WiktorKociuba/drone/dronePCB/dronePCB.kicad_pcb

## KiCad design dronePCB/dronePCB.kicad_pcb (2026-04-25)

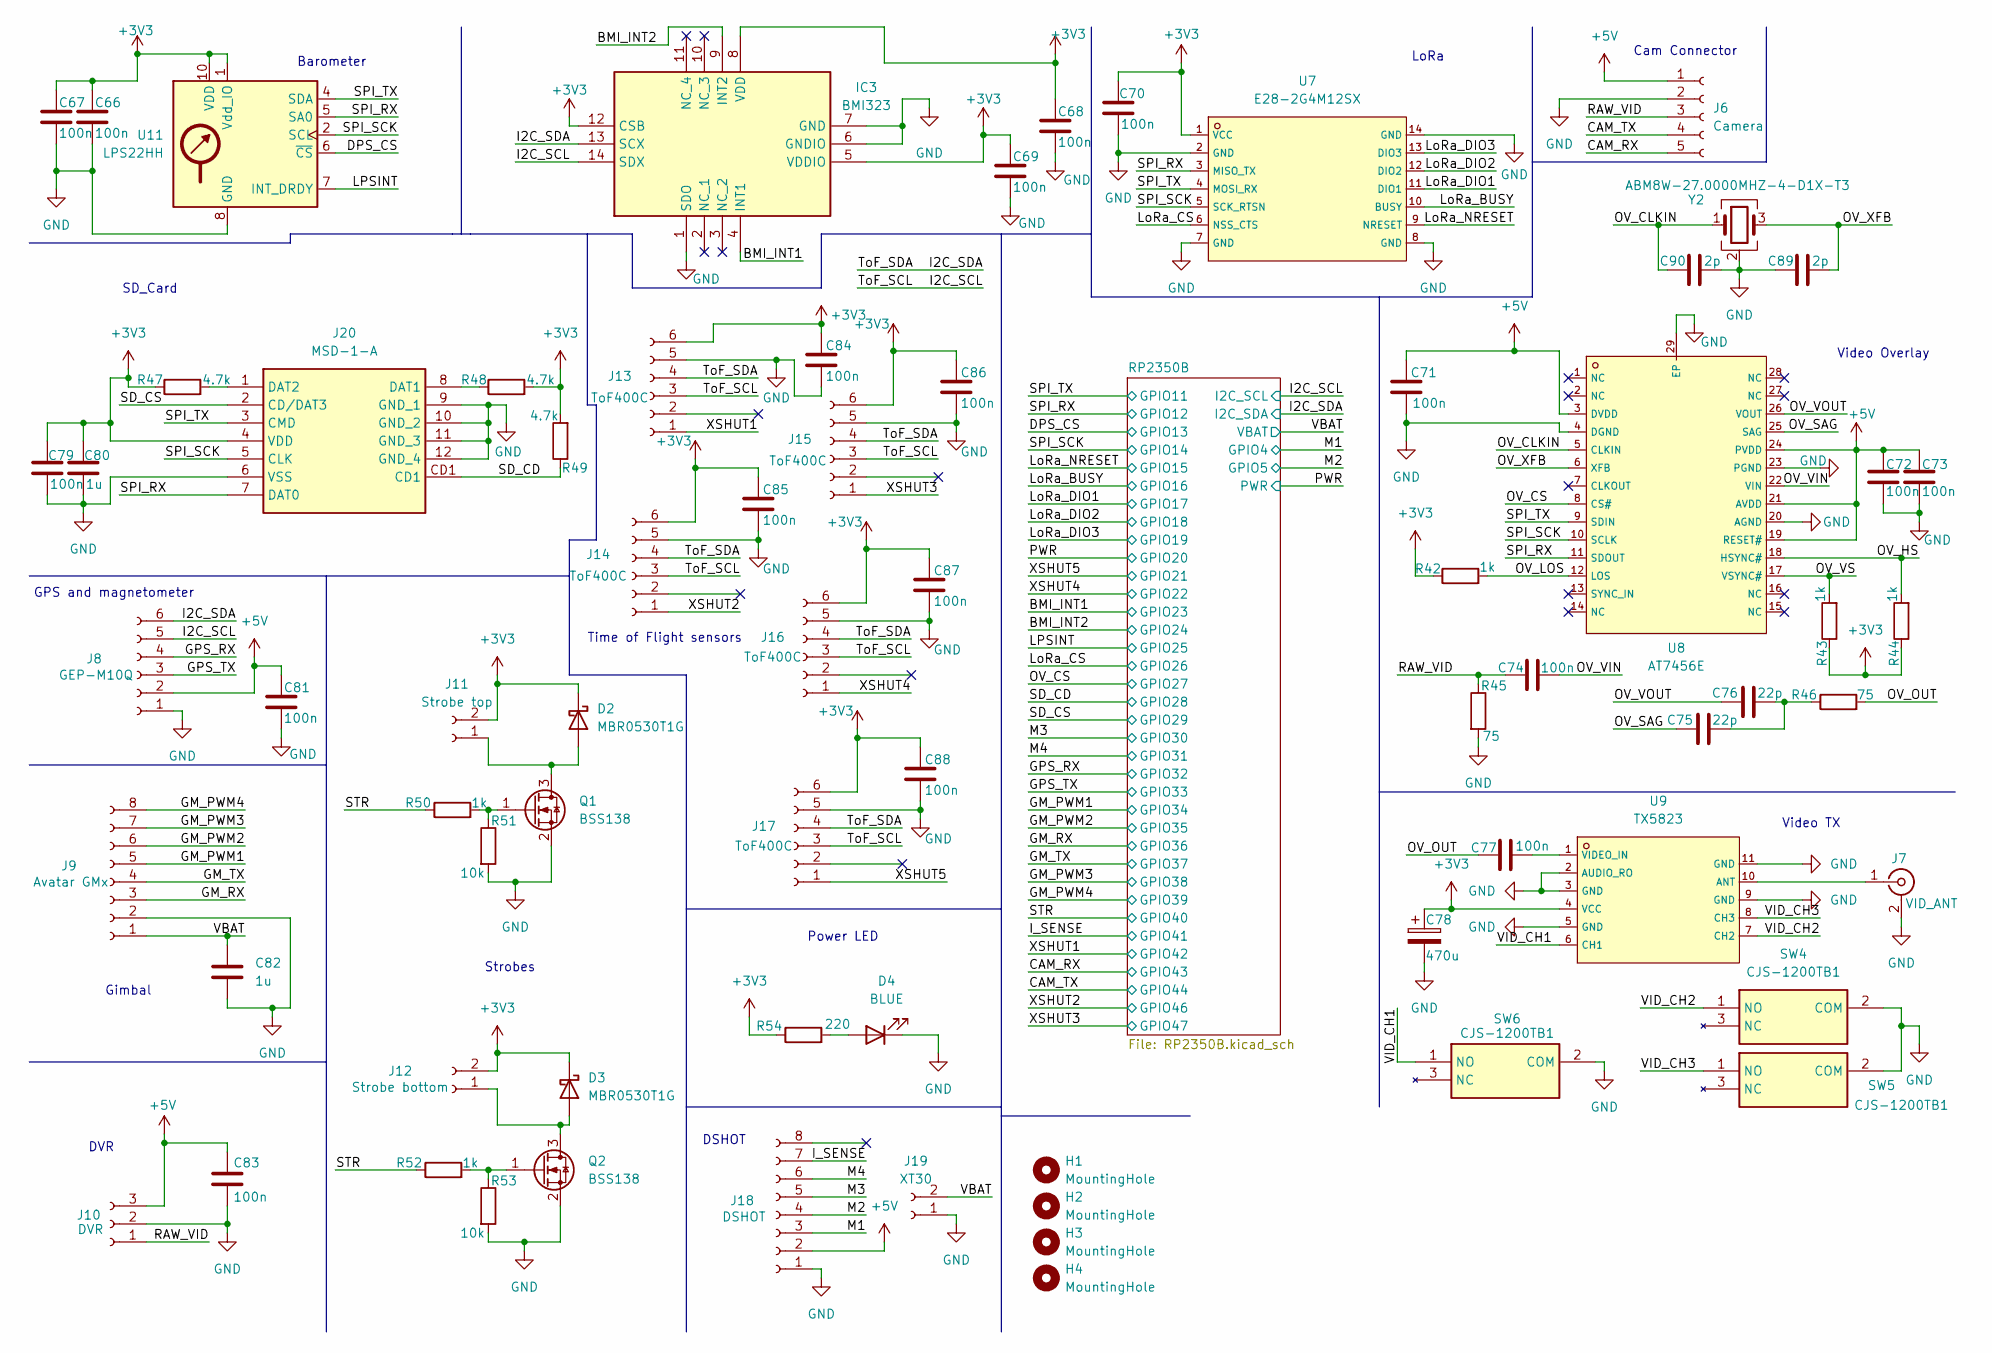
[picture p1: schematic dronePCB.kicad_sch, Main Board]

Parts:
C66, C67, C68, C69, C70, C71, C72, C73, C74, C77, C79, C81, C83, C84, C85, C86, C87, C88: 100n; C_0805_2012Metric_Pad1.18x1.45mm_HandSolder; Manufacturer_Part_Number 08056D104KAT2A
C75, C76: 22p; C_0805_2012Metric_Pad1.18x1.45mm_HandSolder; Manufacturer_Part_Number 0805N220J500CT
C78: 470u; CAPAE830X1080N; Manufacturer_Part_Number UCW1C471MNL1GS
C80, C82: 1u; C_0805_2012Metric_Pad1.18x1.45mm_HandSolder; Manufacturer_Part_Number CL21B105KAFNNNG
C89, C90: 2p; C_0805_2012Metric_Pad1.18x1.45mm_HandSolder; Manufacturer_Part_Number 0805N2R0C500CT
D2, D3: MBR0530T1G; D_SOD-123; Manufacturer_Part_Number MBR0530T1G
D4: BLUE; LED_0805_2012Metric_Pad1.15x1.40mm_HandSolder; Manufacturer_Part_Number 150080BS75000
H1, H2, H3, H4: MountingHole; MountingHole_2.2mm_M2; Manufacturer_Part_Number n/a
IC3: BMI323; Mouser Part Number 262-BMI323
J6: Camera; JST_PH_B5B-PH-SM4-TB_1x05-1MP_P2.00mm_Vertical; Manufacturer_Part_Number B5B-PH-SM4-TB(LF)(SN)
J7: VID_ANT; SMA_Amphenol_132134-11_Vertical; Manufacturer_Part_Number n/a
J8: GEP-M10Q; JST_PH_B6B-PH-SM4-TB_1x06-1MP_P2.00mm_Vertical; Manufacturer_Part_Number B6B-PH-SM4-TB(LF)(SN)
J9: Avatar GMx; JST_PH_B8B-PH-SM4-TB_1x08-1MP_P2.00mm_Vertical; Manufacturer_Part_Number B8B-PH-SM4-TBT(LF)(SN)
J10: DVR; JST_PH_B3B-PH-SM4-TB_1x03-1MP_P2.00mm_Vertical; Manufacturer_Part_Number B3B-PH-SM4-TB(LF)(SN)
J11: Strobe top; JST_PH_B2B-PH-SM4-TB_1x02-1MP_P2.00mm_Vertical; Manufacturer_Part_Number B2B-PH-SM4-TB(LF)(SN)
J12: Strobe bottom; JST_PH_B2B-PH-SM4-TB_1x02-1MP_P2.00mm_Vertical; Manufacturer_Part_Number B2B-PH-SM4-TB(LF)(SN)
J13, J14, J15, J16, J17: ToF400C; JST_PH_B6B-PH-SM4-TB_1x06-1MP_P2.00mm_Vertical; Manufacturer_Part_Number B6B-PH-SM4-TB(LF)(SN)
J18: DSHOT; JST_PH_B8B-PH-SM4-TB_1x08-1MP_P2.00mm_Vertical; Manufacturer_Part_Number B8B-PH-SM4-TBT(LF)(SN)
J19: XT30; AMASS_XT30U-F_1x02_P5.0mm_Vertical; Manufacturer_Part_Number XT30U-F AMASS
J20: MSD-1-A; MSD1A; Mouser Part Number 179-MSD-1-A
Q1, Q2: BSS138; SOT-23; Manufacturer_Part_Number BSS138
R42, R43, R44, R50, R52: 1k; R_0805_2012Metric_Pad1.20x1.40mm_HandSolder; Manufacturer_Part_Number CRM0805-FX-1001ELF
R45, R46: 75; R_0805_2012Metric_Pad1.20x1.40mm_HandSolder; Manufacturer_Part_Number CRCW080575R0FKEA
R47, R48, R49: 4.7k; R_0805_2012Metric_Pad1.20x1.40mm_HandSolder; Manufacturer_Part_Number RG2012P-472-B-T5
R51, R53: 10k; R_0805_2012Metric_Pad1.20x1.40mm_HandSolder; Manufacturer_Part_Number CRM0805-FX-1002ELF
R54: 220; R_0805_2012Metric_Pad1.20x1.40mm_HandSolder; Manufacturer_Part_Number CRCW0805220RFKEA
SW4, SW5, SW6: CJS-1200TB1; CJS1200TB1; Mouser Part Number 229-CJS-1200TB1
U7: E28-2G4M12SX; COMM-SMD_E28-2G4M12SX; Manufacturer_Part_Number E28-2G4M12SX; LCSC C17916848
U8: AT7456E; Manufacturer_Part_Number AT7456E; LCSC C82351
U9: TX5823; Manufacturer_Part_Number TX5823; LCSC C2908188
U11: LPS22HH; ST_HLGA-10_2x2mm_P0.5mm_LayoutBorder3x2y; Manufacturer_Part_Number LPS22HBTR
Y2: ABM8W-27.0000MHZ-4-D1X-T3; ABM8W480000MHZ6D1XT3; Manufacturer_Part_Number ABM8W-27.0000MHZ-4-D1X-T3

Connections:
+3V3: C66.1, C67.1, C68.1, C69.1, C70.1, C78.1, C79.1, C80.1, C84.1, C85.1, C86.1, C87.1, C88.1, D2.1 (K), D3.1 (K), IC3.5 (VDDIO), IC3.8 (VDD), IC3.12 (CSB), J11.2, J12.2, J13.6, J14.6, J15.6, J16.6, J17.6, J20.4 (VDD), R42.1, R43.1, R44.1, R47.1, R48.2, R49.2, R54.1, U7.1 (VCC), U9.4 (VCC), U11.1 (Vdd_IO), U11.10 (VDD); also elsewhere on the board
+5V: C71.1, C72.1, C73.1, C81.1, C83.1, J6.1, J8.2, J10.3, J18.2, U8.3 (DVDD), U8.19 (RESET#), U8.21 (AVDD), U8.24 (PVDD); also elsewhere on the board
/BMI_INT1: IC3.4 (INT1); also elsewhere on the board
/BMI_INT2: IC3.9 (INT2); also elsewhere on the board
/CAM_RX: J6.5; also elsewhere on the board
/CAM_TX: J6.4; also elsewhere on the board
/DPS_CS: U11.6 (~CS); also elsewhere on the board
/GM_PWM1: J9.5; also elsewhere on the board
/GM_PWM2: J9.6; also elsewhere on the board
/GM_PWM3: J9.7; also elsewhere on the board
/GM_PWM4: J9.8; also elsewhere on the board
/GM_RX: J9.3; also elsewhere on the board
/GM_TX: J9.4; also elsewhere on the board
/GPS_RX: J8.4; also elsewhere on the board
/GPS_TX: J8.3; also elsewhere on the board
/I2C_SCL: IC3.14 (SDX), J8.5, J13.3, J14.3, J15.3, J16.3, J17.3; also elsewhere on the board
/I2C_SDA: IC3.13 (SCX), J8.6, J13.4, J14.4, J15.4, J16.4, J17.4; also elsewhere on the board
/I_SENSE: J18.7; also elsewhere on the board
/LPSINT: U11.7 (INT_DRDY); also elsewhere on the board
/LoRa_BUSY: U7.10 (BUSY); also elsewhere on the board
/LoRa_CS: U7.6 (NSS_CTS); also elsewhere on the board
/LoRa_DIO1: U7.11 (DIO1); also elsewhere on the board
/LoRa_DIO2: U7.12 (DIO2); also elsewhere on the board
/LoRa_DIO3: U7.13 (DIO3); also elsewhere on the board
/LoRa_NRESET: U7.9 (NRESET); also elsewhere on the board
/M1: J18.3; also elsewhere on the board
/M2: J18.4; also elsewhere on the board
/M3: J18.5; also elsewhere on the board
/M4: J18.6; also elsewhere on the board
/OV_CLKIN: C90.1, U8.5 (CLKIN), Y2.1
/OV_CS: U8.8 (CS#); also elsewhere on the board
/OV_HS: R44.2, U8.18 (HSYNC#)
/OV_LOS: R42.2, U8.12 (LOS)
/OV_OUT: C77.1, R46.2
/OV_SAG: C75.1, U8.25 (SAG)
/OV_VIN: C74.2, U8.22 (VIN)
/OV_VOUT: C76.1, U8.26 (VOUT)
/OV_VS: R43.2, U8.17 (VSYNC#)
/OV_XFB: C89.2, U8.6 (XFB), Y2.3
/RAW_VID: C74.1, J6.3, J10.1, R45.1
/SD_CD: J20.CD1, R49.1; also elsewhere on the board
/SD_CS: J20.2 (CD/DAT3); also elsewhere on the board
/SPI_RX: J20.7 (DAT0), U7.3 (MISO_TX), U8.11 (SDOUT), U11.5 (SA0); also elsewhere on the board
/SPI_SCK: J20.5 (CLK), U7.5 (SCK_RTSN), U8.10 (SCLK), U11.2 (SCL); also elsewhere on the board
/SPI_TX: J20.3 (CMD), U7.4 (MOSI_RX), U8.9 (SDIN), U11.4 (SDA); also elsewhere on the board
/STR: R50.1, R52.1; also elsewhere on the board
/VBAT: C82.1, J9.1, J19.2; also elsewhere on the board
/VID_CH1: SW6.1 (NO), U9.6 (CH1)
/VID_CH2: SW4.1 (NO), U9.7 (CH2)
/VID_CH3: SW5.1 (NO), U9.8 (CH3)
/XSHUT1: J13.1; also elsewhere on the board
/XSHUT2: J14.1; also elsewhere on the board
/XSHUT3: J15.1; also elsewhere on the board
/XSHUT4: J16.1; also elsewhere on the board
/XSHUT5: J17.1; also elsewhere on the board
GND: C66.2, C67.2, C68.2, C69.2, C70.2, C71.2, C72.2, C73.2, C78.2, C79.2, C80.2, C81.2, C82.2, C83.2, C84.2, C85.2, C86.2, C87.2, C88.2, C89.1, C90.2, D4.1 (K), IC3.1 (SDO), IC3.6 (GNDIO), IC3.7 (GND), J6.2, J7.2 (Ext), J8.1, J9.2, J10.2, J13.5, J14.5, J15.5, J16.5, J17.5, J18.1, J19.1, J20.6 (VSS), J20.9 (GND_1), J20.10 (GND_2), J20.11 (GND_3), J20.12 (GND_4), Q1.2 (S), Q2.2 (S), R45.2, R51.2, R53.2, SW4.2 (COM), SW5.2 (COM), SW6.2 (COM), U7.2 (GND), U7.7 (GND), U7.8 (GND), U7.14 (GND), U8.4 (DGND), U8.20 (AGND), U8.23 (PGND), U8.29 (EP), U9.2 (AUDIO_RO), U9.3 (GND), U9.5 (GND), U9.9 (GND), U9.11 (GND), U11.3 (GND), U11.8 (GND), U11.9 (GND), Y2.2 (G), Y2.4 (G); also elsewhere on the board
unnamed: C75.2, C76.2, R46.1
unnamed: D2.2 (A), J11.1, Q1.3 (D)
unnamed: D3.2 (A), J12.1, Q2.3 (D)
unnamed: D4.2 (A), R54.2
unnamed: J7.1 (In), U9.10 (ANT)
unnamed: J20.8 (DAT1), R48.1
unnamed: J20.1 (DAT2), R47.2
unnamed: Q1.1 (G), R50.2, R51.1
unnamed: Q2.1 (G), R52.2, R53.1
unnamed: C77.2, U9.1 (VIDEO_IN)

Notes on the sheet:
Video Overlay
Strobes
DVR
Gimbal
GPS and magnetometer
Power LED
Time of Flight sensors
LoRa
Cam Connector
Barometer
SD_Card
DSHOT
Video TX

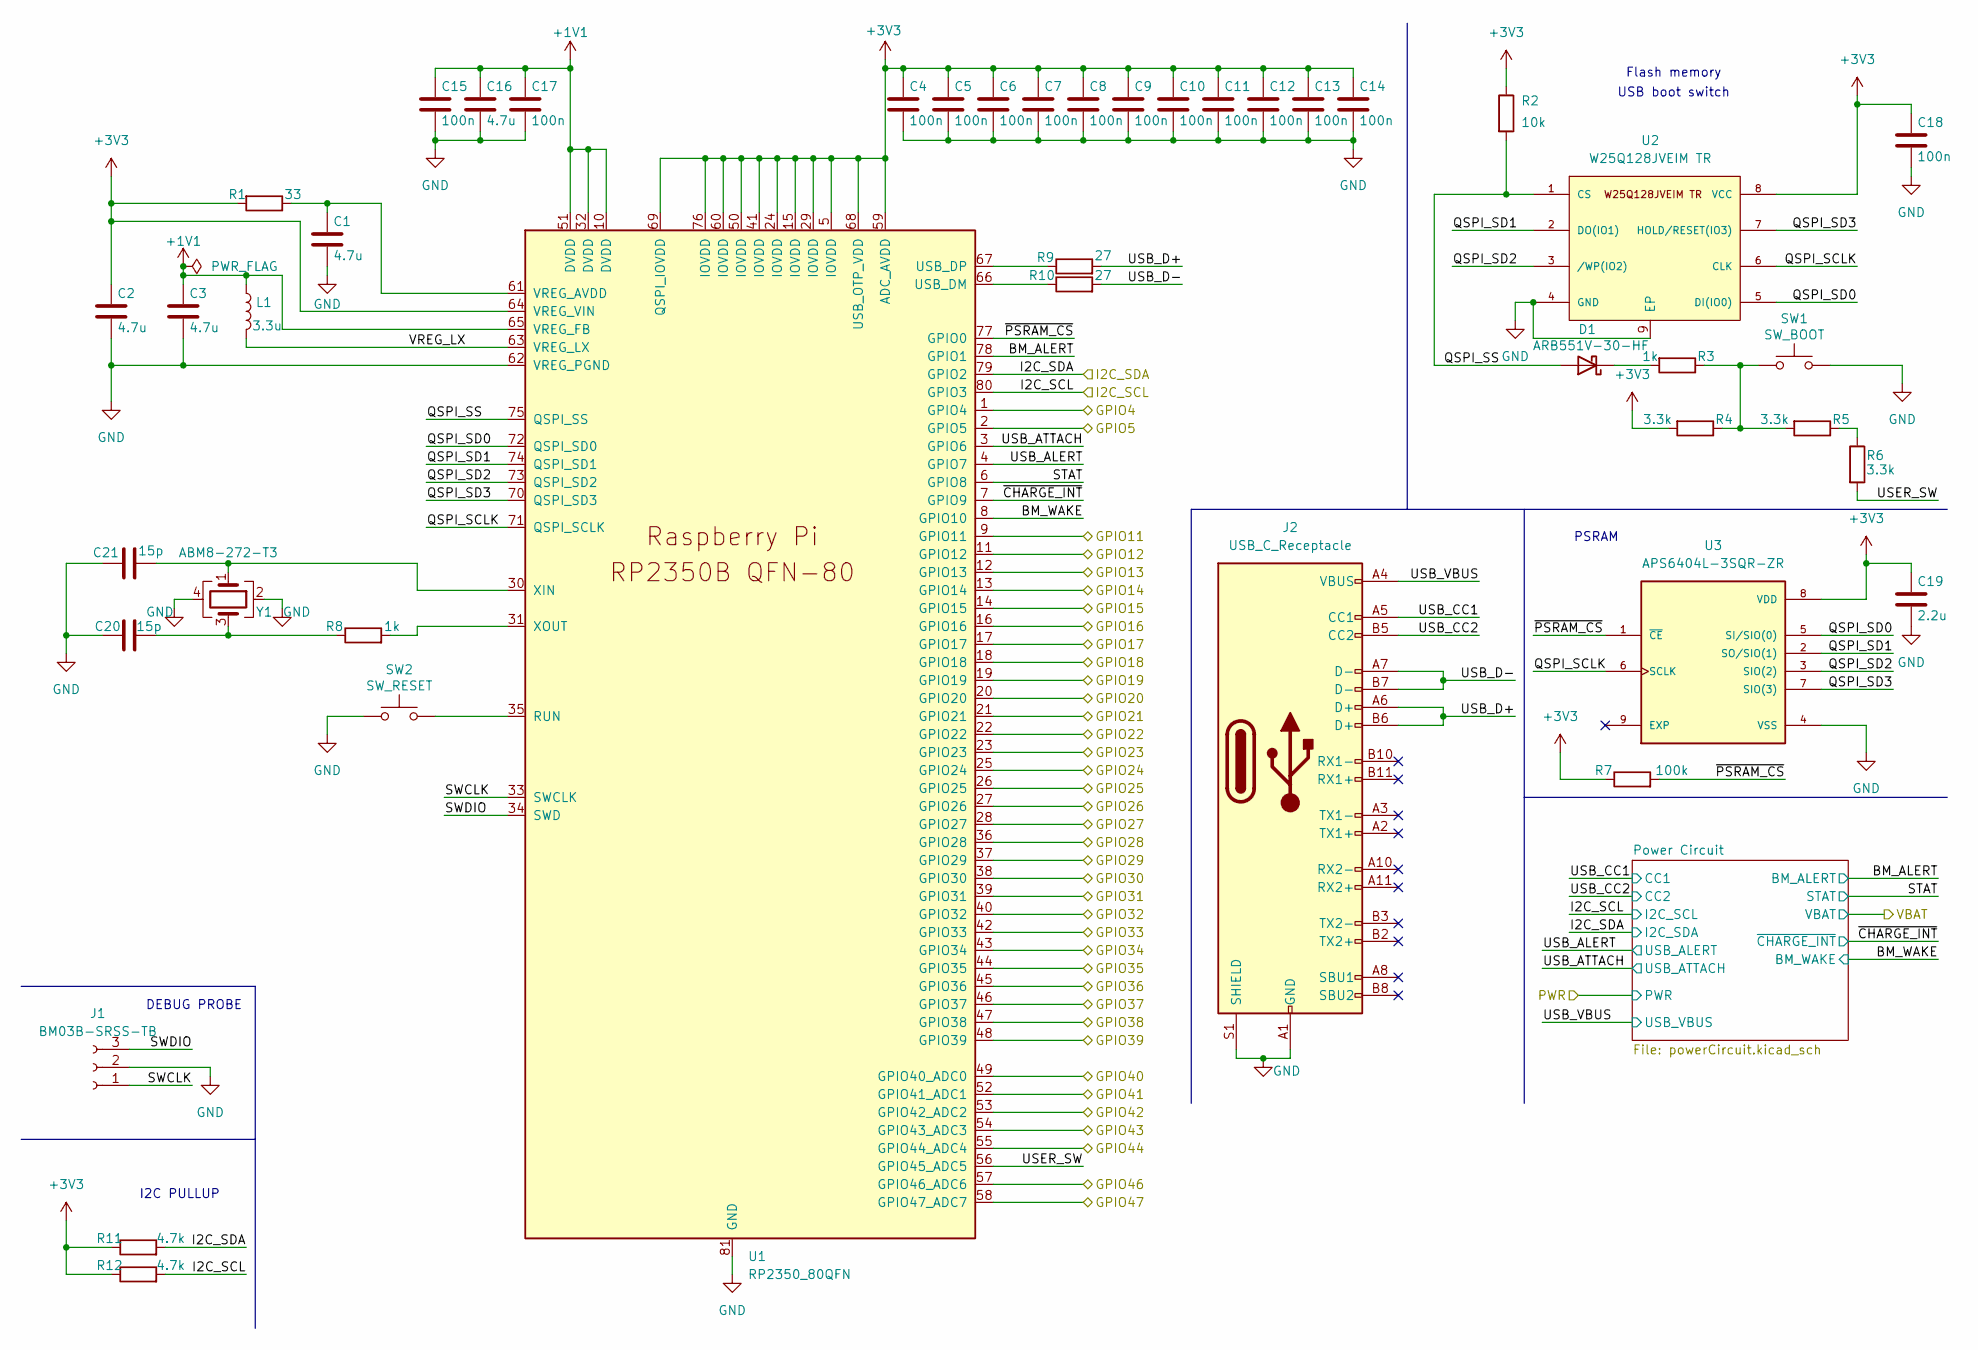
[picture p2: schematic RP2350B.kicad_sch]

Parts:
C1, C16: 4.7u; C_0805_2012Metric_Pad1.18x1.45mm_HandSolder; Manufacturer_Part_Number CL21A475KPFNNNF
C2, C3: 4.7u; C_0402_1005Metric_Pad0.74x0.62mm_HandSolder; Manufacturer_Part_Number CL05A475KQ5NRNC
C4, C5, C6, C7, C8, C9, C10, C11, C12, C13, C14, C15, C17, C18: 100n; C_0805_2012Metric_Pad1.18x1.45mm_HandSolder; Manufacturer_Part_Number 08056D104KAT2A
C19: 2.2u; C_0805_2012Metric_Pad1.18x1.45mm_HandSolder; Manufacturer_Part_Number CL21B225KPFNNNE
C20, C21: 15p; C_0805_2012Metric_Pad1.18x1.45mm_HandSolder; Manufacturer_Part_Number C0805C150K1HACTU
D1: ARB551V-30-HF; D_SOD-323_HandSoldering; Manufacturer_Part_Number ARB551V-30-HF
J1: BM03B-SRSS-TB; JST_SH_BM03B-SRSS-TB_1x03-1MP_P1.00mm_Vertical; Manufacturer_Part_Number BM03B-SRSS-TB
J2: USB_C_Receptacle; USB_C_Receptacle_Amphenol_12401610E4-2A; Manufacturer_Part_Number 12401610E4#2A
L1: 3.3u; AOTAB201610S3R3101T; Manufacturer_Part_Number AOTA-B201610S3R3-101-T
R1: 33; R_0805_2012Metric_Pad1.20x1.40mm_HandSolder; Manufacturer_Part_Number CRCW080533R0JNEA
R2: 10k; R_0805_2012Metric_Pad1.20x1.40mm_HandSolder; Manufacturer_Part_Number CRM0805-FX-1002ELF
R3, R8: 1k; R_0805_2012Metric_Pad1.20x1.40mm_HandSolder; Manufacturer_Part_Number CRM0805-FX-1001ELF
R4, R5, R6: 3.3k; R_0805_2012Metric_Pad1.20x1.40mm_HandSolder; Manufacturer_Part_Number SG73S2ARTTD3301F
R7: 100k; R_0805_2012Metric_Pad1.20x1.40mm_HandSolder; Manufacturer_Part_Number CR0805AFX-1003EAS
R9, R10: 27; R_0805_2012Metric_Pad1.20x1.40mm_HandSolder; Manufacturer_Part_Number CRCW080527R0FKEA
R11, R12: 4.7k; R_0805_2012Metric_Pad1.20x1.40mm_HandSolder; Manufacturer_Part_Number RG2012P-472-B-T5
SW1: SW_BOOT; SW_Push_1P1T_NO_Vertical_Wuerth_434133025816; Manufacturer_Part_Number 434133025816
SW2: SW_RESET; SW_Push_1P1T_NO_Vertical_Wuerth_434133025816; Manufacturer_Part_Number 434133025816
U1: RP2350_80QFN; RP2350B; Manufacturer_Part_Number SC1510(13)-A4
U2: W25Q128JVEIM TR; SON127P800X600X80-9N-D; Manufacturer_Part_Number W25Q128JVEIM TR
U3: APS6404L-3SQR-ZR; PSON50P200X300X50-9N; PARTREV 2.3
Y1: ABM8-272-T3; ABM8272T3; Manufacturer_Part_Number ABM8-272-T3

Connections:
+1V1: C3.1, C15.1, C16.1, C17.1, L1.1, U1.10 (DVDD), U1.32 (DVDD), U1.51 (DVDD), U1.65 (VREG_FB)
+3V3: C2.1, C4.1, C5.1, C6.1, C7.1, C8.1, C9.1, C10.1, C11.1, C12.1, C13.1, C14.1, C18.1, C19.1, R1.2, R2.1, R4.2, R7.1, R11.1, R12.1, U1.5 (IOVDD), U1.15 (IOVDD), U1.24 (IOVDD), U1.29 (IOVDD), U1.41 (IOVDD), U1.50 (IOVDD), U1.59 (ADC_AVDD), U1.60 (IOVDD), U1.64 (VREG_VIN), U1.68 (USB_OTP_VDD), U1.69 (QSPI_IOVDD), U1.76 (IOVDD), U2.8 (VCC), U3.8 (VDD); also elsewhere on the board
/BMI_INT1: U1.23 (GPIO23); also elsewhere on the board
/BMI_INT2: U1.25 (GPIO24); also elsewhere on the board
/CAM_RX: U1.54 (GPIO43_ADC3); also elsewhere on the board
/CAM_TX: U1.55 (GPIO44_ADC4); also elsewhere on the board
/DPS_CS: U1.12 (GPIO13); also elsewhere on the board
/GM_PWM1: U1.43 (GPIO34); also elsewhere on the board
/GM_PWM2: U1.44 (GPIO35); also elsewhere on the board
/GM_PWM3: U1.47 (GPIO38); also elsewhere on the board
/GM_PWM4: U1.48 (GPIO39); also elsewhere on the board
/GM_RX: U1.45 (GPIO36); also elsewhere on the board
/GM_TX: U1.46 (GPIO37); also elsewhere on the board
/GPS_RX: U1.40 (GPIO32); also elsewhere on the board
/GPS_TX: U1.42 (GPIO33); also elsewhere on the board
/I2C_SCL: R12.2, U1.80 (GPIO3); also elsewhere on the board
/I2C_SDA: R11.2, U1.79 (GPIO2); also elsewhere on the board
/I_SENSE: U1.52 (GPIO41_ADC1); also elsewhere on the board
/LPSINT: U1.26 (GPIO25); also elsewhere on the board
/LoRa_BUSY: U1.16 (GPIO16); also elsewhere on the board
/LoRa_CS: U1.27 (GPIO26); also elsewhere on the board
/LoRa_DIO1: U1.17 (GPIO17); also elsewhere on the board
/LoRa_DIO2: U1.18 (GPIO18); also elsewhere on the board
/LoRa_DIO3: U1.19 (GPIO19); also elsewhere on the board
/LoRa_NRESET: U1.14 (GPIO15); also elsewhere on the board
/M1: U1.1 (GPIO4); also elsewhere on the board
/M2: U1.2 (GPIO5); also elsewhere on the board
/M3: U1.38 (GPIO30); also elsewhere on the board
/M4: U1.39 (GPIO31); also elsewhere on the board
/OV_CS: U1.28 (GPIO27); also elsewhere on the board
/PWR: U1.20 (GPIO20); also elsewhere on the board
/RP2350B/BM_ALERT: U1.78 (GPIO1); also elsewhere on the board
/RP2350B/BM_WAKE: U1.8 (GPIO10); also elsewhere on the board
/RP2350B/QSPI_SCLK: U1.71 (QSPI_SCLK), U2.6 (CLK), U3.6 (SCLK)
/RP2350B/QSPI_SD0: U1.72 (QSPI_SD0), U2.5 (DI(IO0)), U3.5 (SI/SIO(0))
/RP2350B/QSPI_SD1: U1.74 (QSPI_SD1), U2.2 (DO(IO1)), U3.2 (SO/SIO(1))
/RP2350B/QSPI_SD2: U1.73 (QSPI_SD2), U2.3 (/WP(IO2)), U3.3 (SIO(2))
/RP2350B/QSPI_SD3: U1.70 (QSPI_SD3), U2.7 (HOLD/RESET(IO3)), U3.7 (SIO(3))
/RP2350B/QSPI_SS: D1.2 (A), R2.2, U1.75 (QSPI_SS), U2.1 (CS)
/RP2350B/STAT: U1.6 (GPIO8); also elsewhere on the board
/RP2350B/SWCLK: J1.1, U1.33 (SWCLK)
/RP2350B/SWDIO: J1.3, U1.34 (SWD)
/RP2350B/USB_ALERT: U1.4 (GPIO7); also elsewhere on the board
/RP2350B/USB_ATTACH: U1.3 (GPIO6); also elsewhere on the board
/RP2350B/USB_CC1: J2.A5 (CC1); also elsewhere on the board
/RP2350B/USB_CC2: J2.B5 (CC2); also elsewhere on the board
/RP2350B/USB_D+: J2.A6 (D+), J2.B6 (D+), R9.2
/RP2350B/USB_D-: J2.A7 (D-), J2.B7 (D-), R10.2
/RP2350B/USB_VBUS: J2.A4 (VBUS), J2.A9 (VBUS), J2.B4 (VBUS), J2.B9 (VBUS); also elsewhere on the board
/RP2350B/USER_SW: R6.2, U1.56 (GPIO45_ADC5)
/RP2350B/VREG_LX: L1.2, U1.63 (VREG_LX)
/RP2350B/~CHARGE_INT: U1.7 (GPIO9); also elsewhere on the board
/RP2350B/~PSRAM_CS: R7.2, U1.77 (GPIO0), U3.1 (~CE)
/SD_CD: U1.36 (GPIO28); also elsewhere on the board
/SD_CS: U1.37 (GPIO29); also elsewhere on the board
/SPI_RX: U1.11 (GPIO12); also elsewhere on the board
/SPI_SCK: U1.13 (GPIO14); also elsewhere on the board
/SPI_TX: U1.9 (GPIO11); also elsewhere on the board
/STR: U1.49 (GPIO40_ADC0); also elsewhere on the board
/XSHUT1: U1.53 (GPIO42_ADC2); also elsewhere on the board
/XSHUT2: U1.57 (GPIO46_ADC6); also elsewhere on the board
/XSHUT3: U1.58 (GPIO47_ADC7); also elsewhere on the board
/XSHUT4: U1.22 (GPIO22); also elsewhere on the board
/XSHUT5: U1.21 (GPIO21); also elsewhere on the board
GND: C1.2, C2.2, C3.2, C4.2, C5.2, C6.2, C7.2, C8.2, C9.2, C10.2, C11.2, C12.2, C13.2, C14.2, C15.2, C16.2, C17.2, C18.2, C19.2, C20.1, C21.1, J1.2, J2.A1 (GND), J2.A12 (GND), J2.B1 (GND), J2.B12 (GND), J2.S1 (SHIELD), SW1.2, SW2.1, U1.62 (VREG_PGND), U1.81 (GND), U2.4 (GND), U2.9 (GND), U3.4 (VSS), Y1.2, Y1.4; also elsewhere on the board
unnamed: C20.2, R8.1, Y1.3
unnamed: D1.1 (K), R3.2
unnamed: R3.1, R4.1, R5.2, SW1.1
unnamed: R5.1, R6.1
unnamed: SW2.2, U1.35 (RUN)
unnamed: R10.1, U1.66 (USB_DM)
unnamed: R9.1, U1.67 (USB_DP)
unnamed: C1.1, R1.1, U1.61 (VREG_AVDD)
unnamed: C21.2, U1.30 (XIN), Y1.1
unnamed: R8.2, U1.31 (XOUT)

Notes on the sheet:
PSRAM
I2C PULLUP
DEBUG PROBE
Flash memory
USB boot switch

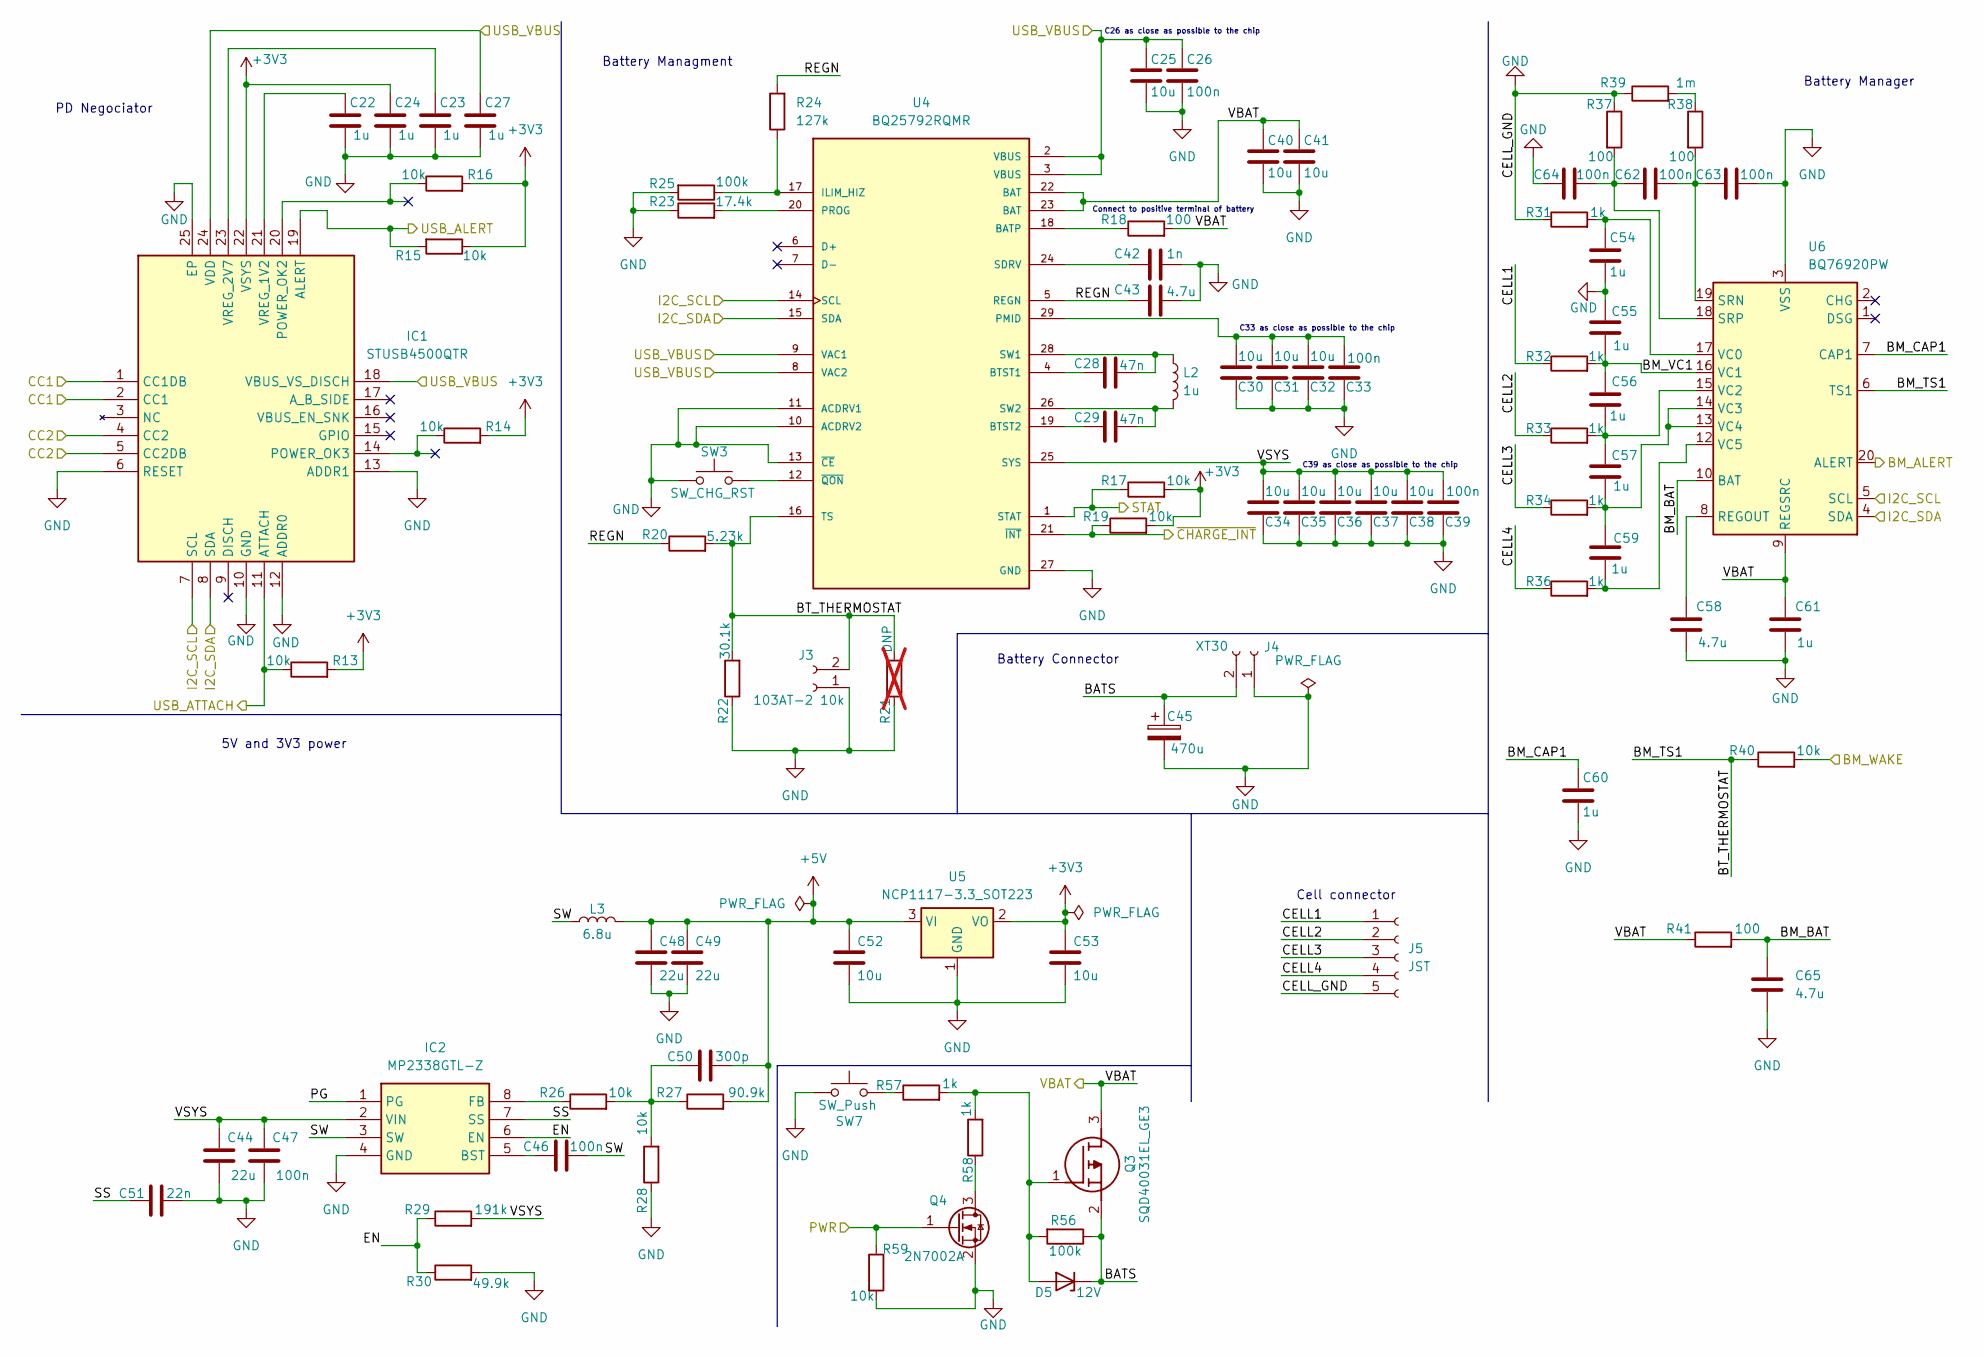
[picture p3: schematic powerCircuit.kicad_sch, Power Circuit]

Parts:
C22, C23, C24, C27, C54, C55, C56, C57, C59, C60, C61: 1u; C_0805_2012Metric_Pad1.18x1.45mm_HandSolder; Manufacturer_Part_Number CL21B105KAFNNNG
C25, C30, C31, C32, C34, C35, C36, C37, C38, C40, C41, C52, C53: 10u; C_0805_2012Metric_Pad1.18x1.45mm_HandSolder; Manufacturer_Part_Number CL21A106KOQNNNE
C26, C33, C39, C46, C47, C62, C63, C64: 100n; C_0805_2012Metric_Pad1.18x1.45mm_HandSolder; Manufacturer_Part_Number 08056D104KAT2A
C28, C29: 47n; C_0805_2012Metric_Pad1.18x1.45mm_HandSolder; Manufacturer_Part_Number KGM21NR71C473KT
C42: 1n; C_0805_2012Metric_Pad1.18x1.45mm_HandSolder; Manufacturer_Part_Number CL21B102KBCNNNC
C43, C58, C65: 4.7u; C_0805_2012Metric_Pad1.18x1.45mm_HandSolder; Manufacturer_Part_Number CL21A475KPFNNNF
C44, C48, C49: 22u; C_0805_2012Metric_Pad1.18x1.45mm_HandSolder; Manufacturer_Part_Number CL21A226KQCLRNC
C45: 470u; CAPAE830X1080N; Manufacturer_Part_Number UCW1C471MNL1GS
C50: 300p; C_0805_2012Metric_Pad1.18x1.45mm_HandSolder; Manufacturer_Part_Number 0805N301J500CT
C51: 22n; C_0805_2012Metric_Pad1.18x1.45mm_HandSolder; Manufacturer_Part_Number CC0805KRX7R7BB223
D5: 12V; SOD3716X135N; Manufacturer_Part_Number MMSZ4699T1G
IC1: STUSB4500QTR; Mouser Part Number 511-STUSB4500QTR
IC2: MP2338GTL-Z; MP2338GTLZ; Mouser Part Number 946-MP2338GTL-Z
J3: 103AT-2 10k; JST_PH_B2B-PH-SM4-TB_1x02-1MP_P2.00mm_Vertical; Manufacturer_Part_Number B2B-PH-SM4-TB(LF)(SN)
J4: XT30; AMASS_XT30U-F_1x02_P5.0mm_Vertical; Manufacturer_Part_Number XT30U-F AMASS
J5: JST; JST_PH_B5B-PH-SM4-TB_1x05-1MP_P2.00mm_Vertical; Manufacturer_Part_Number B5B-PH-SM4-TB(LF)(SN)
L2: 1u; AMPLH7020S-1R0MT; Manufacturer_Part_Number AMPLH7020S-1R0MT
L3: 6.8u; AMPLH5030S-6R8MT; Manufacturer_Part_Number AMPLH5030S-6R8MT
Q3: SQD40031EL_GE3; Mouser Part Number 78-SQD40031EL_GE3
Q4: 2N7002A; SOT-23; Manufacturer_Part_Number 2N7002A
R13, R14, R15, R16, R17, R19, R26, R28, R40, R59: 10k; R_0805_2012Metric_Pad1.20x1.40mm_HandSolder; Manufacturer_Part_Number CRM0805-FX-1002ELF
R18, R37, R38, R41: 100; R_0805_2012Metric_Pad1.20x1.40mm_HandSolder; Manufacturer_Part_Number RMCA0805FT100R-HP
R20: 5.23k; R_0805_2012Metric_Pad1.20x1.40mm_HandSolder; Manufacturer_Part_Number RT0805FRE075K23L
R21: DNP; R_0805_2012Metric_Pad1.20x1.40mm_HandSolder; Manufacturer_Part_Number n/a; not fitted
R22: 30.1k; R_0805_2012Metric_Pad1.20x1.40mm_HandSolder; Manufacturer_Part_Number RT0805DRE0730K1L
R23: 17.4k; R_0805_2012Metric_Pad1.20x1.40mm_HandSolder; Manufacturer_Part_Number CR0805-FX-1742ELF
R24: 127k; R_0805_2012Metric_Pad1.20x1.40mm_HandSolder; Manufacturer_Part_Number RT0805FRE07127KL
R25, R56: 100k; R_0805_2012Metric_Pad1.20x1.40mm_HandSolder; Manufacturer_Part_Number CR0805AFX-1003EAS
R27: 90.9k; R_0805_2012Metric_Pad1.20x1.40mm_HandSolder; Manufacturer_Part_Number RT0805FRE0790K9L
R29: 191k; R_0805_2012Metric_Pad1.20x1.40mm_HandSolder; Manufacturer_Part_Number RT0805FRE07191KL
R30: 49.9k; R_0805_2012Metric_Pad1.20x1.40mm_HandSolder; Manufacturer_Part_Number RT0805FRD0749K9L
R31, R32, R33, R34, R36, R57, R58: 1k; R_0805_2012Metric_Pad1.20x1.40mm_HandSolder; Manufacturer_Part_Number CRM0805-FX-1001ELF
R39: 1m; R_0805_2012Metric_Pad1.20x1.40mm_HandSolder; Manufacturer_Part_Number CSSH0805FT1L00
SW3: SW_CHG_RST; SW_Push_1P1T_NO_Vertical_Wuerth_434133025816; Manufacturer_Part_Number 434133025816
SW7: SW_Push; SW_Push_1P1T-MP_NO_Horizontal_Alps_SKRTLAE010; Manufacturer_Part_Number SKRTLAE010
U4: BQ25792RQMR; PARTREV 11/2019
U5: NCP1117-3.3_SOT223; SOT-223-3_TabPin2; Manufacturer_Part_Number NCP1117ST33T3G
U6: BQ76920PW; TSSOP-20_4.4x6.5mm_P0.65mm; Manufacturer_Part_Number BQ7692000PW

Connections:
+3V3: C24.1, C53.1, IC1.22 (VSYS), R13.2, R14.2, R15.1, R16.2, R17.2, R19.2, U5.2 (VO); also elsewhere on the board
+5V: C48.1, C49.1, C50.2, C52.1, L3.2, R27.2, U5.3 (VI); also elsewhere on the board
/I2C_SCL: IC1.7 (SCL), U4.14 (SCL), U6.5 (SCL); also elsewhere on the board
/I2C_SDA: IC1.8 (SDA), U4.15 (SDA), U6.4 (SDA); also elsewhere on the board
/PWR: Q4.1 (G), R59.1; also elsewhere on the board
/RP2350B/BM_ALERT: U6.20 (ALERT); also elsewhere on the board
/RP2350B/BM_WAKE: R40.2; also elsewhere on the board
/RP2350B/Power Circuit/BATS: C45.1, D5.1 (K), J4.2 (Pin_1), Q3.2 (S), R56.1
/RP2350B/Power Circuit/BM_BAT: C65.1, R41.2, U6.10 (BAT)
/RP2350B/Power Circuit/BM_CAP1: C60.1, U6.7 (CAP1)
/RP2350B/Power Circuit/BM_TS1: J3.2, R20.2, R21.2, R22.2, R40.1, U4.16 (TS), U6.6 (TS1)
/RP2350B/Power Circuit/BM_VC1: C55.2, C56.1, R32.2, U6.16 (VC1)
/RP2350B/Power Circuit/CELL1: J5.1, R32.1
/RP2350B/Power Circuit/CELL2: J5.2, R33.1
/RP2350B/Power Circuit/CELL3: J5.3, R34.1
/RP2350B/Power Circuit/CELL4: J5.4, R36.1
/RP2350B/Power Circuit/EN: IC2.6 (EN), R29.1, R30.1
/RP2350B/Power Circuit/PG: IC2.1 (PG)
/RP2350B/Power Circuit/REGN: C43.1, R20.1, R24.2, U4.5 (REGN)
/RP2350B/Power Circuit/SS: C51.1, IC2.7 (SS)
/RP2350B/Power Circuit/SW: C46.2, IC2.3 (SW), L3.1
/RP2350B/Power Circuit/VSYS: C34.2, C35.2, C36.2, C37.2, C38.2, C39.2, C44.1, C47.1, IC2.2 (VIN), R29.2, U4.25 (SYS)
/RP2350B/STAT: R17.1, U4.1 (STAT); also elsewhere on the board
/RP2350B/USB_ALERT: IC1.19 (ALERT), R15.2; also elsewhere on the board
/RP2350B/USB_ATTACH: IC1.11 (ATTACH), R13.1; also elsewhere on the board
/RP2350B/USB_CC1: IC1.1 (CC1DB), IC1.2 (CC1); also elsewhere on the board
/RP2350B/USB_CC2: IC1.4 (CC2), IC1.5 (CC2DB); also elsewhere on the board
/RP2350B/USB_VBUS: C25.1, C26.1, C27.1, IC1.18 (VBUS_VS_DISCH), IC1.24 (VDD), U4.2 (VBUS), U4.3 (VBUS), U4.8 (VAC2), U4.9 (VAC1); also elsewhere on the board
/RP2350B/~CHARGE_INT: R19.1, U4.21 (~INT); also elsewhere on the board
/VBAT: C40.1, C41.1, C61.1, Q3.3 (D), R18.2, R41.1, U4.22 (BAT), U4.23 (BAT), U6.9 (REGSRC); also elsewhere on the board
GND: C22.2, C23.2, C24.2, C25.2, C26.2, C27.2, C30.1, C31.1, C32.1, C33.1, C34.1, C35.1, C36.1, C37.1, C38.1, C39.1, C40.2, C41.2, C42.2, C43.2, C44.2, C45.2, C47.2, C48.2, C49.2, C51.2, C52.2, C53.2, C54.2, C55.1, C58.2, C60.2, C61.2, C63.2, C64.1, C65.2, IC1.6 (RESET), IC1.10 (GND), IC1.12 (ADDR0), IC1.13 (ADDR1), IC1.25 (EP), IC2.4 (GND), J3.1, J4.1 (Pin_2), J5.5, Q4.2 (S), R21.1, R22.1, R23.1, R25.2, R28.1, R30.2, R31.1, R37.1, R39.1, R59.2, SW3.1, SW7.1, U4.10 (ACDRV2), U4.11 (ACDRV1), U4.13 (~CE), U4.27 (GND), U5.1 (GND), U6.3 (VSS); also elsewhere on the board
unnamed: C50.1, R26.2, R27.1, R28.2
unnamed: D5.2 (A), Q3.1 (G), R56.2, R57.2, R58.2
unnamed: C22.1, IC1.21 (VREG_1V2)
unnamed: C23.1, IC1.23 (VREG_2V7)
unnamed: C46.1, IC2.5 (BST)
unnamed: IC2.8 (FB), R26.1
unnamed: Q4.3 (D), R58.1
unnamed: R38.1, R39.2
unnamed: R57.1, SW7.2
unnamed: R18.1, U4.18 (BATP)
unnamed: C28.1, U4.4 (BTST1)
unnamed: C29.1, U4.19 (BTST2)
unnamed: R24.1, R25.1, U4.17 (ILIM_HIZ)
unnamed: C30.2, C31.2, C32.2, C33.2, U4.29 (PMID)
unnamed: R23.2, U4.20 (PROG)
unnamed: C42.1, U4.24 (SDRV)
unnamed: C28.2, L2.1, U4.28 (SW1)
unnamed: C29.2, L2.2, U4.26 (SW2)
unnamed: SW3.2, U4.12 (~QON)
unnamed: C58.1, U6.8 (REGOUT)
unnamed: C62.2, C63.1, R38.2, U6.19 (SRN)
unnamed: C62.1, C64.2, R37.2, U6.18 (SRP)
unnamed: C54.1, R31.2, U6.17 (VC0)
unnamed: C56.2, C57.1, R33.2, U6.15 (VC2)
unnamed: C57.2, C59.1, R34.2, U6.13 (VC4), U6.14 (VC3)
unnamed: C59.2, R36.2, U6.12 (VC5)

Notes on the sheet:
C39 as close as possible to the chip
Battery Managment
C26 as close as possible to the chip
Cell connector
Battery Connector
Battery Manager
C33 as close as possible to the chip
PD Negociator
Connect to positive terminal of battery
5V and 3V3 power
