WiktorKociuba/drone/dronePCB/dronePCB.kicad_pcb

## KiCad design dronePCB/dronePCB.kicad_pcb (continued)

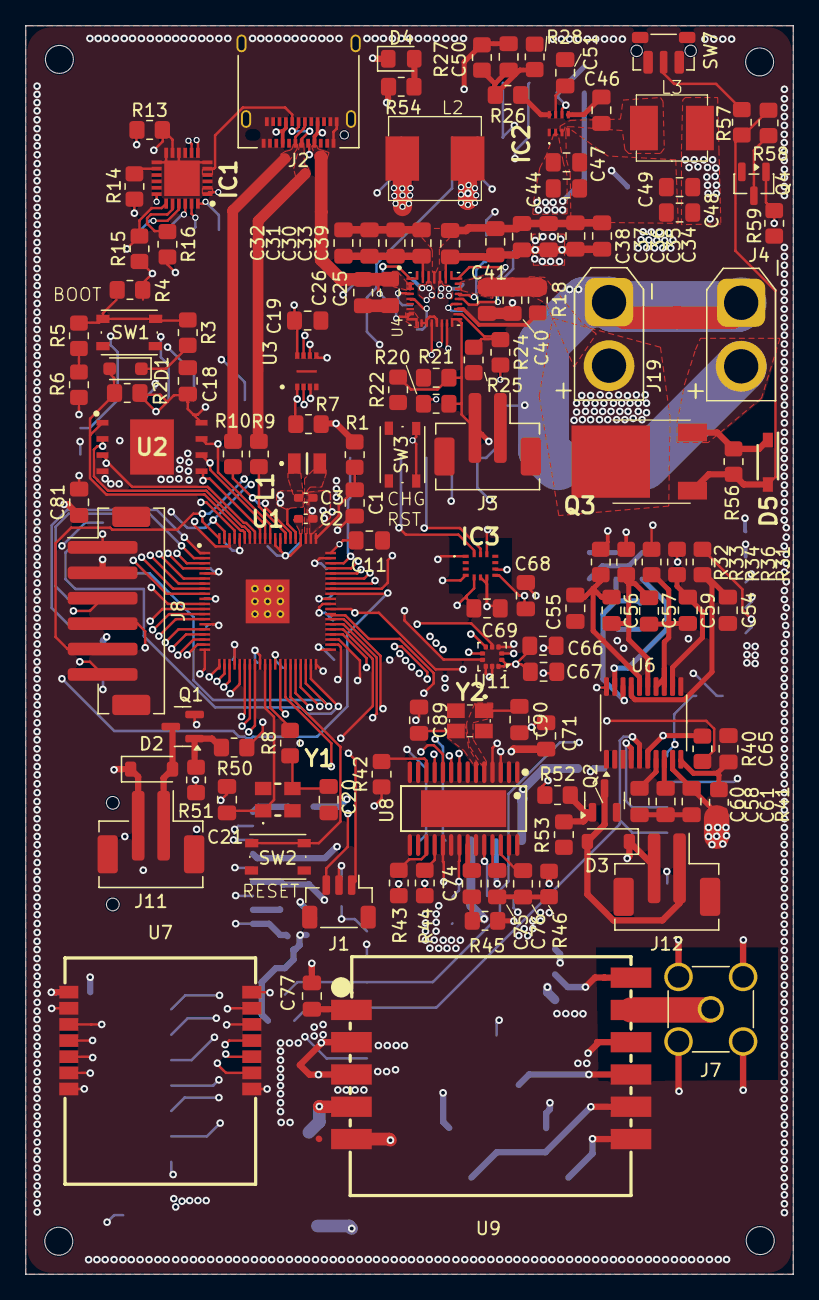
[picture p4: board dronePCB.kicad_pcb from above]

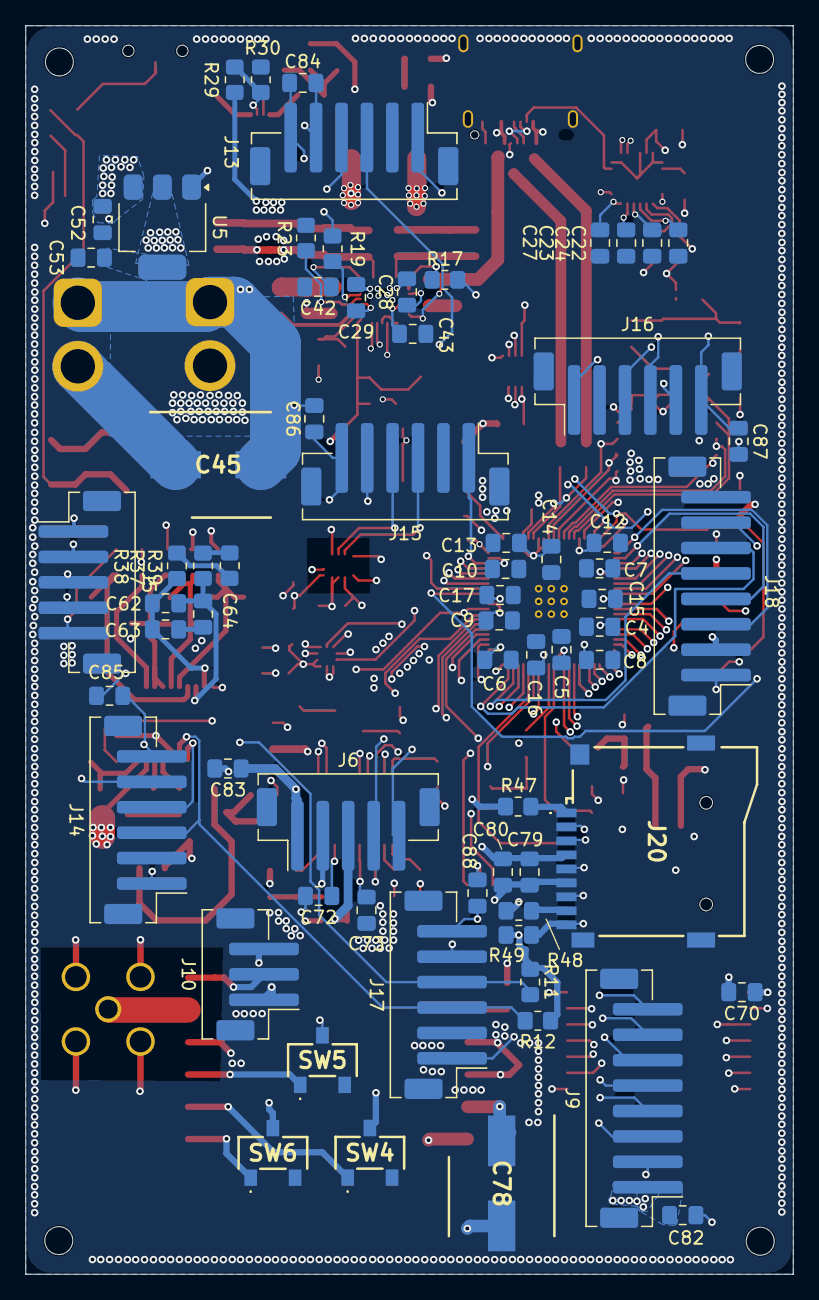
[picture p5: board dronePCB.kicad_pcb from below]

Board: 6 copper layers, 60.4 x 98.2 mm, 205 parts (68 on the bottom side), 140 nets.
