WiktorKociuba/drone/strobePCB/strobePCB.kicad_pcb

## KiCad design strobePCB/strobePCB.kicad_pcb (2026-04-07)

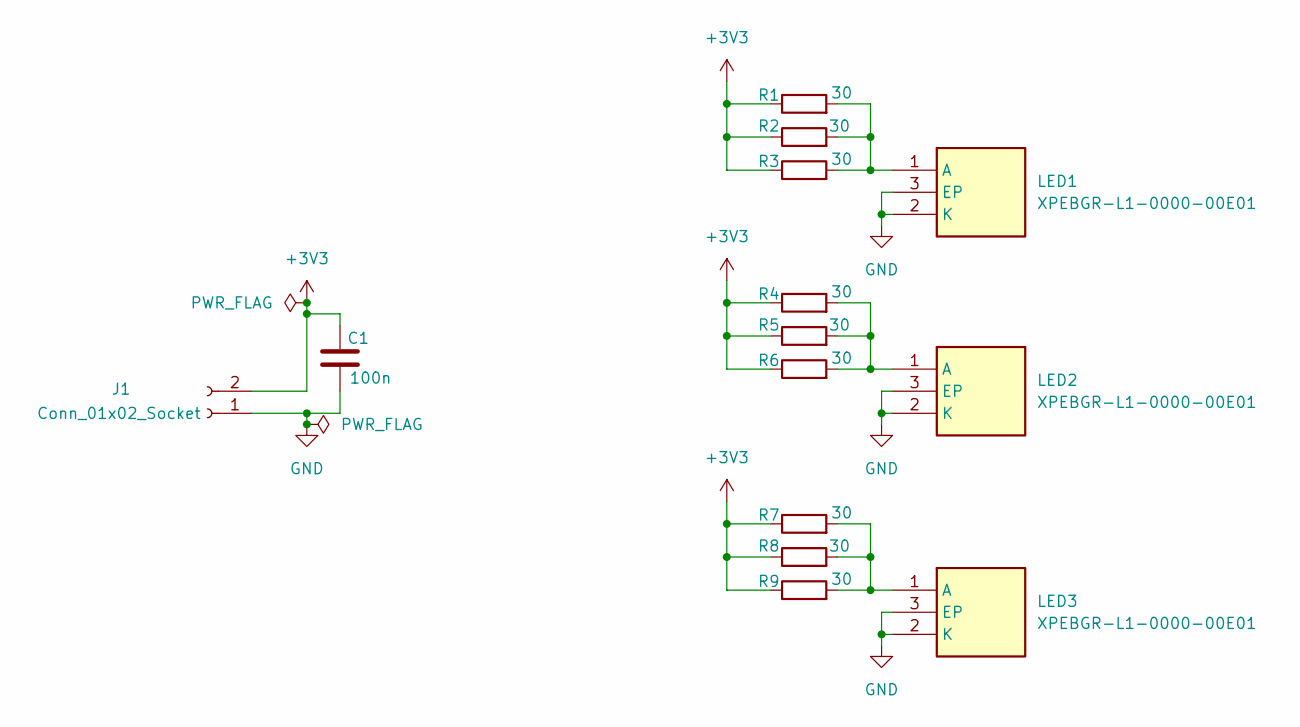
[picture p6: schematic strobePCB.kicad_sch, Strobe Light for Drones]

Parts:
C1: 100n; C_0805_2012Metric
J1: Conn_01x02_Socket; JST_PH_B2B-PH-K_1x02_P2.00mm_Vertical
LED1, LED2, LED3: XPEBGR-L1-0000-00E01; XPEBGRL1000000E01; Mouser Part Number 941-XPEBGRL10000E01
R1, R2, R3, R4, R5, R6, R7, R8, R9: 30; R_1210_3225Metric_Pad1.30x2.65mm_HandSolder

Connections:
+3V3: C1.1, J1.2, R1.1, R2.1, R3.1, R4.1, R5.1, R6.1, R7.1, R8.1, R9.1
GND: C1.2, J1.1, LED1.2 (K), LED1.3 (EP), LED2.2 (K), LED2.3 (EP), LED3.2 (K), LED3.3 (EP)
unnamed: LED1.1 (A), R1.2, R2.2, R3.2
unnamed: LED2.1 (A), R4.2, R5.2, R6.2
unnamed: LED3.1 (A), R7.2, R8.2, R9.2

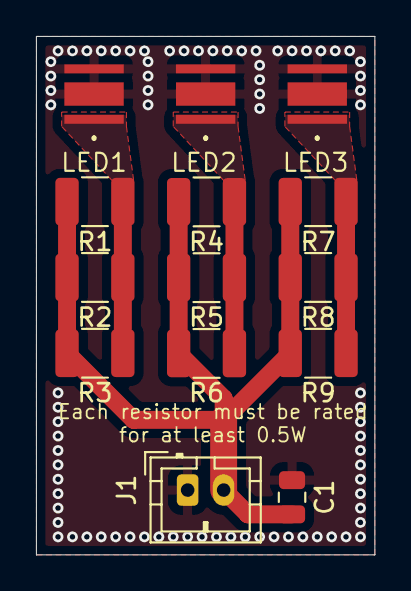
[picture p7: board strobePCB.kicad_pcb from above]

Board: 2 copper layers, 18.8 x 28.8 mm, 14 parts (0 on the bottom side), 5 nets.
