WiktorKociuba/drone/(commit log)

2026-03-27 Added RP2350B and all dependencies, power circuit, IMU, barometer and radio comms.
    [dronePCB.kicad_pcb, dronePCB.kicad_sch, powerCircuit.kicad_sch, untitled.kicad_sch]
2026-03-30 Added micro sd card slot
    [dronePCB.kicad_sch]
2026-03-31 Added micro SD, GPS, magnetometer, gimbal, DVR, Strobes and ToF sensors
    [RP2350B.kicad_sch, dronePCB.kicad_sch, powerCircuit.kicad_sch]
2026-04-01 Added strobe PCB
    [dronePCB.kicad_sch, powerCircuit.kicad_sch, strobePCB.kicad_pcb, strobePCB.kicad_sch]
2026-04-07 Routed RP2350B w/ dependencies + power circuit
    [RP2350B.kicad_sch, dronePCB.kicad_pcb, dronePCB.kicad_sch, powerCircuit.kicad_sch, strobePCB.kicad_pcb]
2026-04-08 Finished PCB
    [RP2350B.kicad_sch, dronePCB.kicad_pcb, dronePCB.kicad_sch]
2026-04-08 Added 3d models to the pcb
    [RP2350B.kicad_sch, dronePCB.kicad_pcb, dronePCB.kicad_sch, powerCircuit.kicad_sch]
2026-04-08 added missing models
    [dronePCB.kicad_pcb]
2026-04-22 Added power switch
    [RP2350B.kicad_sch, dronePCB.kicad_pcb, dronePCB.kicad_sch, powerCircuit.kicad_sch, untitled.kicad_sch]
2026-04-23 Started filling the BoM and changed some components
    [RP2350B.kicad_sch, dronePCB.kicad_pcb, dronePCB.kicad_sch, powerCircuit.kicad_sch]
2026-04-24 Added more information to BoM
    [RP2350B.kicad_sch, dronePCB.kicad_pcb, dronePCB.kicad_sch, powerCircuit.kicad_sch]
2026-04-25 Finished the BoM
    [RP2350B.kicad_sch, dronePCB.kicad_pcb, dronePCB.kicad_sch, powerCircuit.kicad_sch]
2026-04-25 Embedded 3d models
    [dronePCB.kicad_pcb, dronePCB.kicad_sch]
